kyuditsky/catpaw/README.md

# catpaw
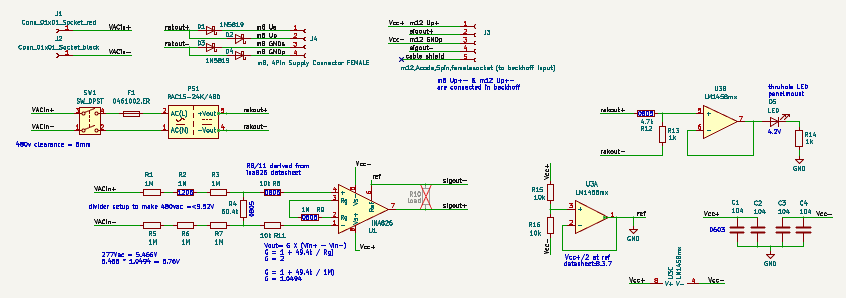
[picture p1: images/catpaw_scheme_072026.png]


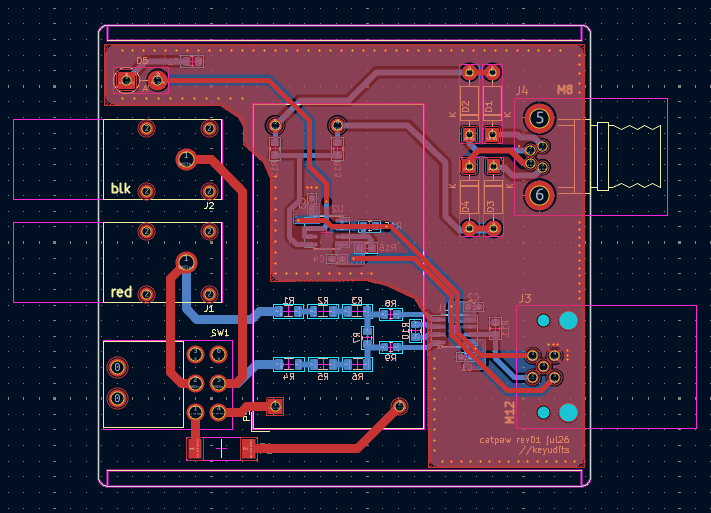
[picture p2: images/catpaw_pcbnew_route03.png]
