kyuditsky/catpaw/images/1MD1TB1M6QES.png

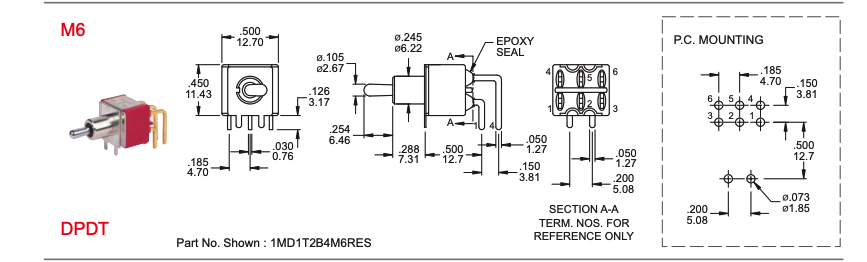
images/1MD1TB1M6QES.png
