kyuditsky/catpaw/images/catpaw2-0_pcb.png

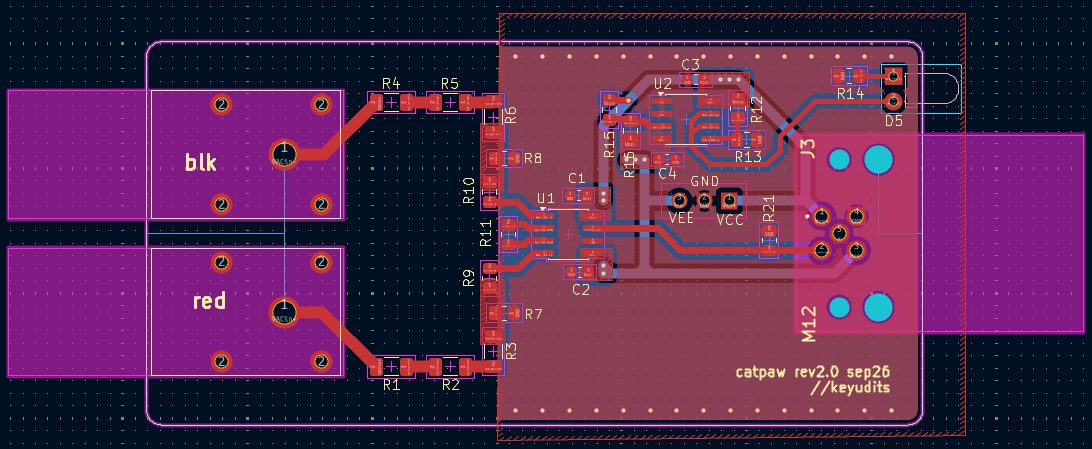
images/catpaw2-0_pcb.png
