kyuditsky/catpaw/images/catpaw2-0_scheme.png

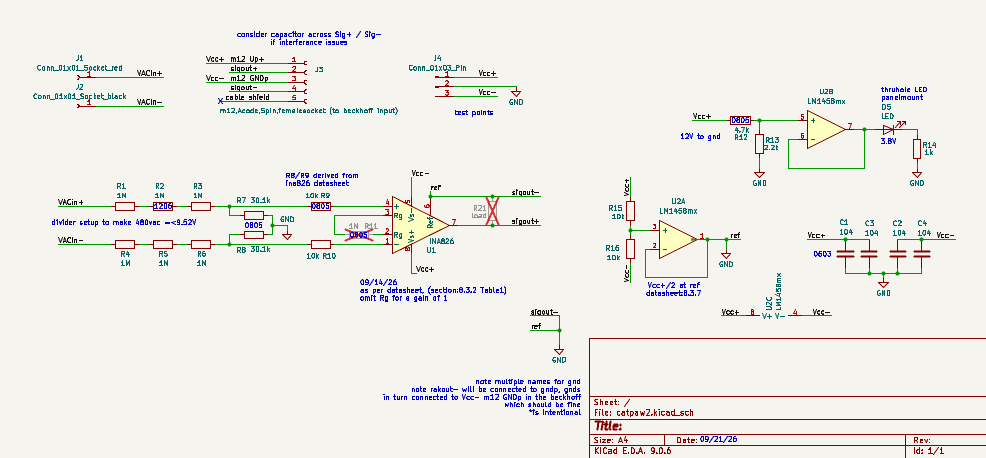
images/catpaw2-0_scheme.png
