kyuditsky/catpaw/images/catpaw_div1.png

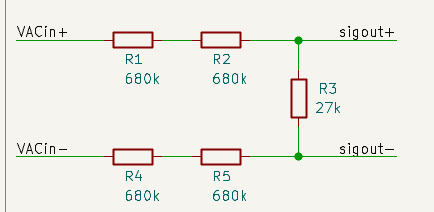
images/catpaw_div1.png
