kyuditsky/catpaw/images/catpaw_div2.png

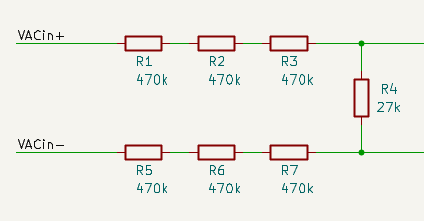
images/catpaw_div2.png
