kyuditsky/catpaw/images/catpaw_div3.png

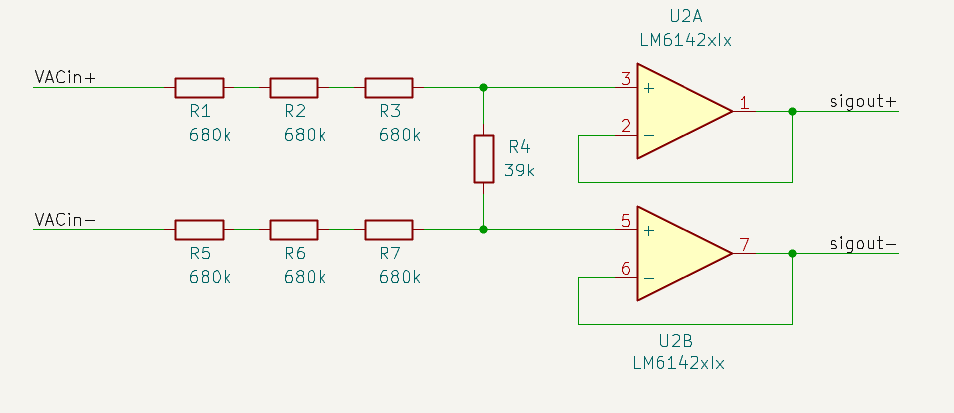
images/catpaw_div3.png
