kyuditsky/catpaw/images/catpaw_div4.png

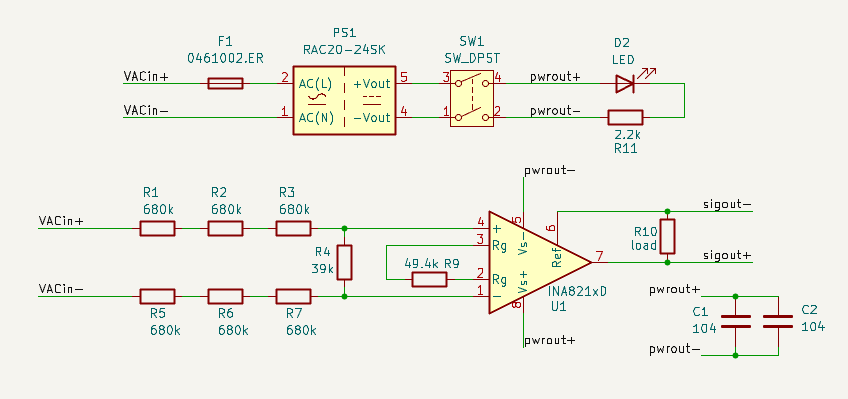
images/catpaw_div4.png
