kyuditsky/catpaw/images/catpaw_draft1.png

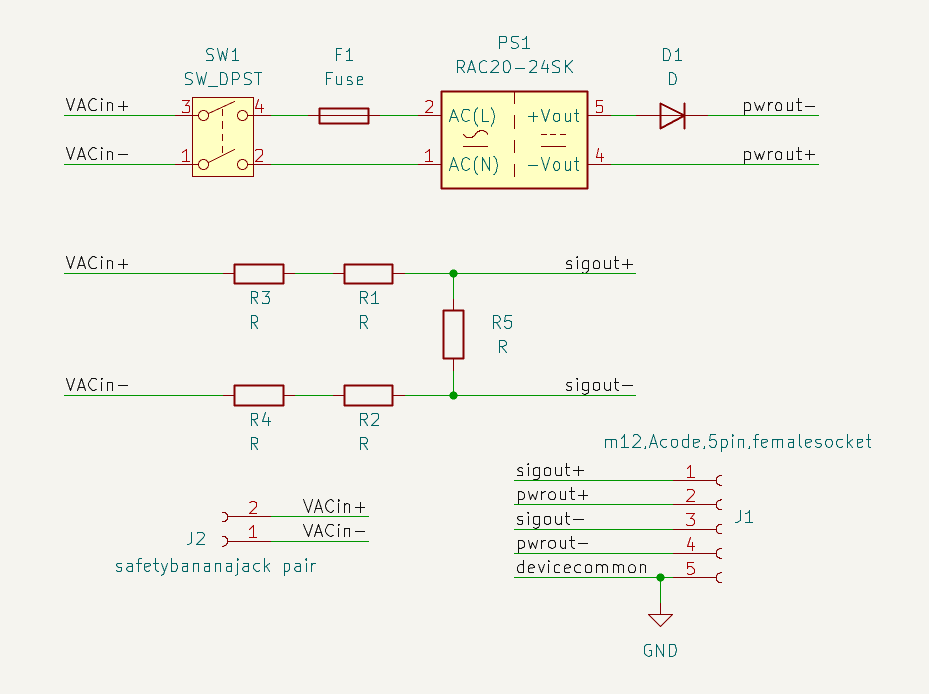
images/catpaw_draft1.png
