kyuditsky/catpaw/images/catpaw_pcbnew_route01.png

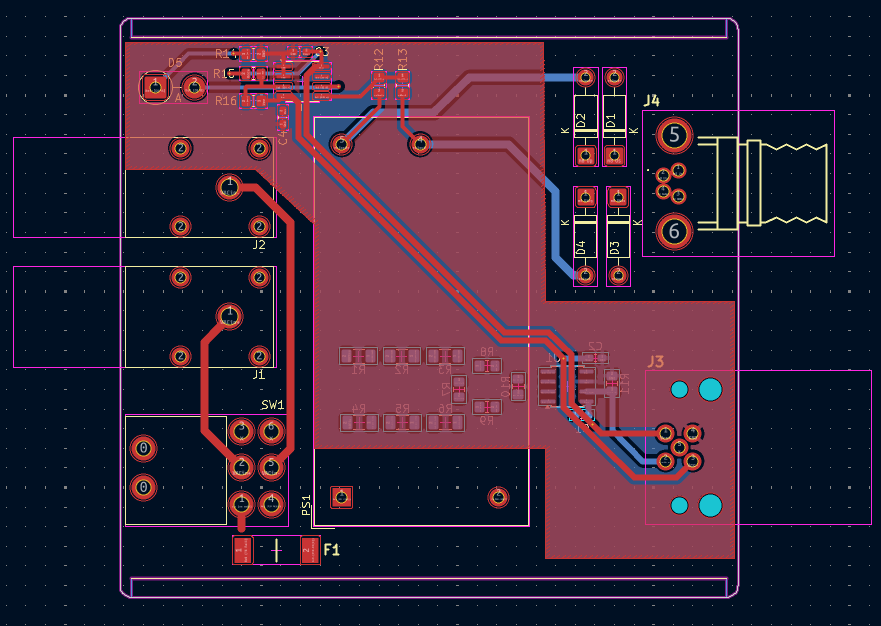
images/catpaw_pcbnew_route01.png
