kyuditsky/catpaw/images/catpaw_rev2_prod1.png

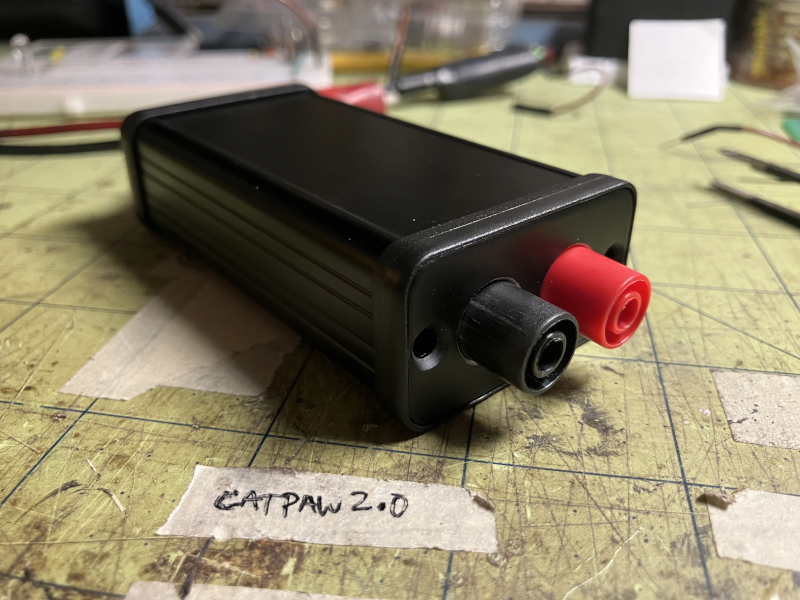
images/catpaw_rev2_prod1.png
