kyuditsky/catpaw/images/catpaw_rev2_prod2.png

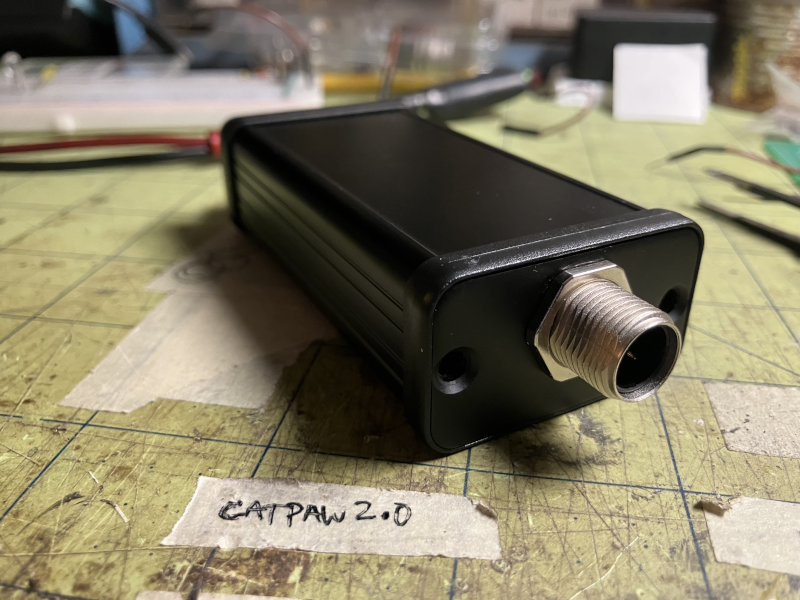
images/catpaw_rev2_prod2.png
