kyuditsky/catpaw/images/catpaw_scheme051226_02.png

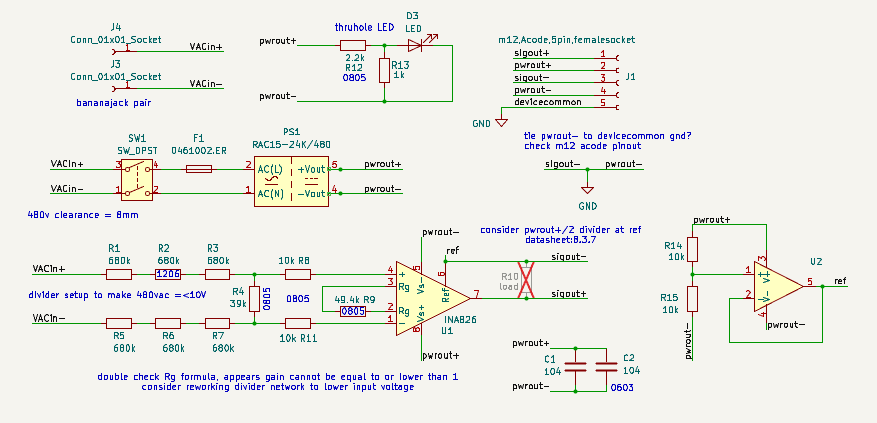
images/catpaw_scheme051226_02.png
