kyuditsky/catpaw/images/catpaw_scheme051326_01.png

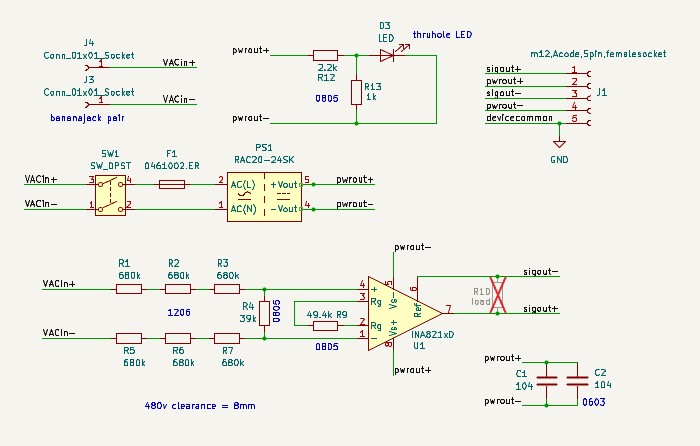
images/catpaw_scheme051326_01.png
