kyuditsky/catpaw/images/catpaw_scribbles.png

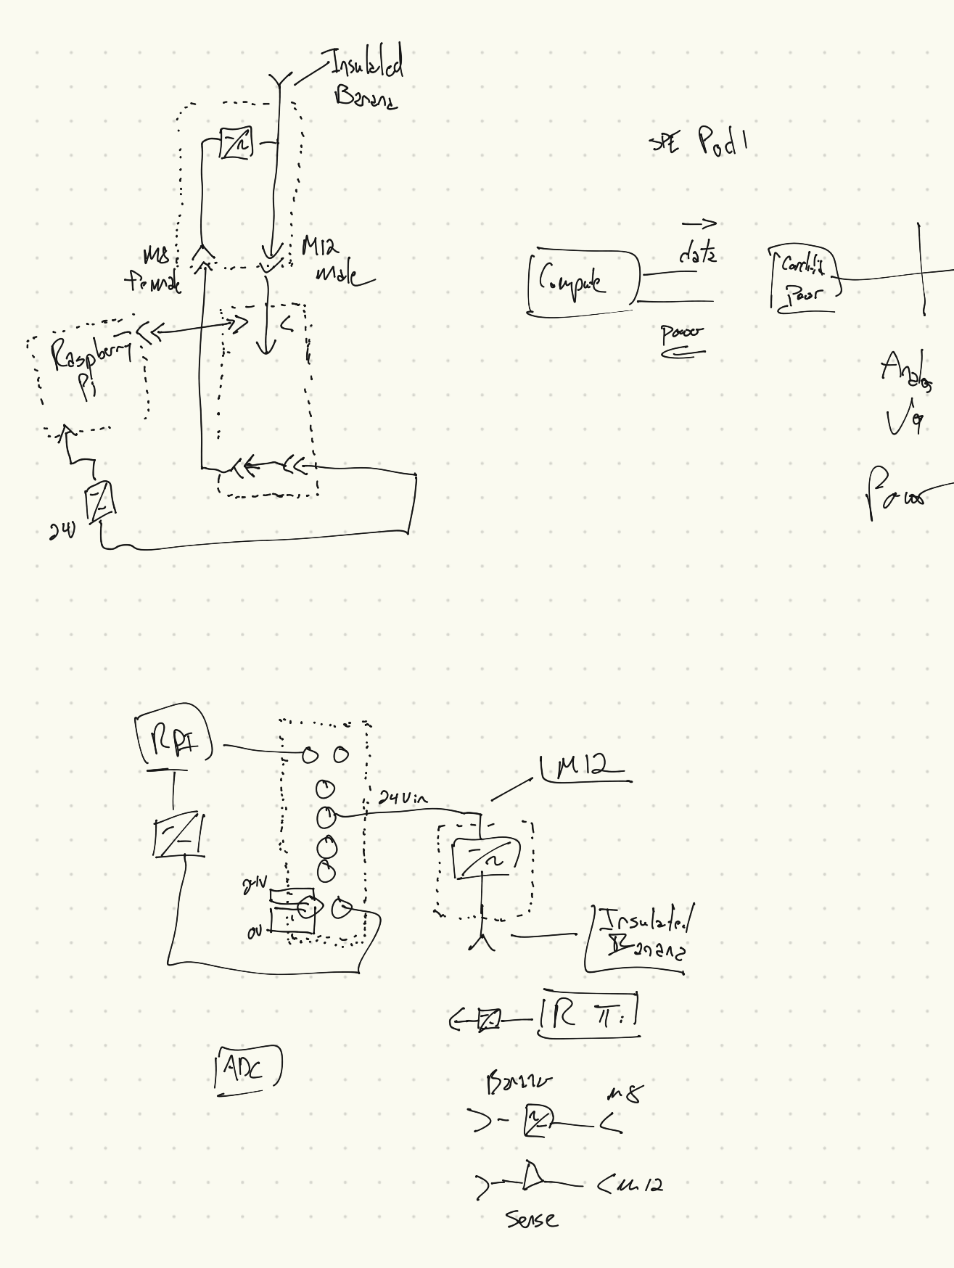
images/catpaw_scribbles.png
