kyuditsky/catpaw/images/catpawrev01_01.png

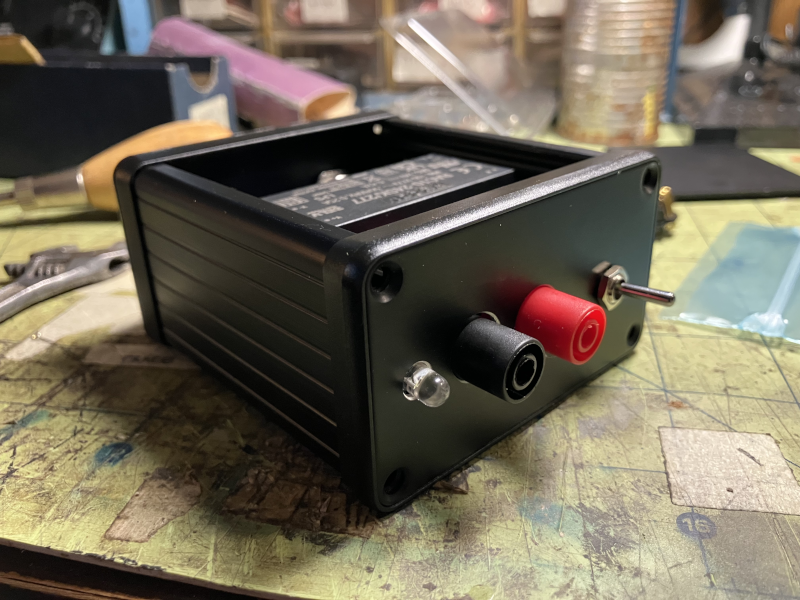
images/catpawrev01_01.png
