kyuditsky/catpaw/images/catpawrev01_02.png

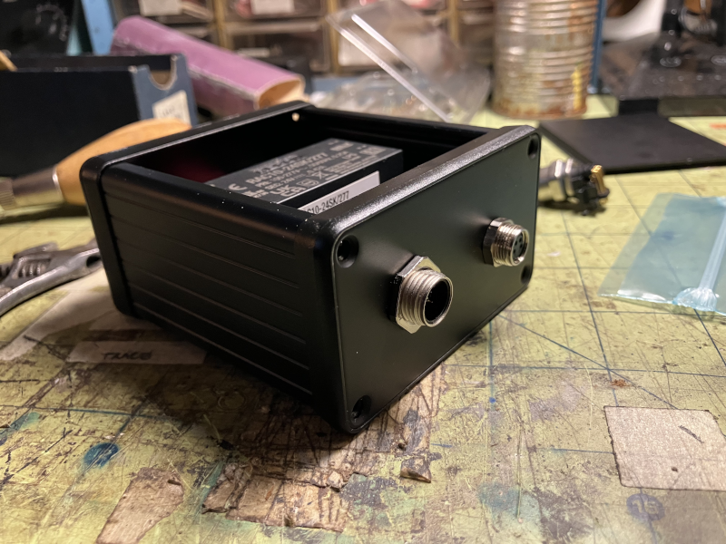
images/catpawrev01_02.png
