kyuditsky/catpaw/images/catpawrev01_03.png

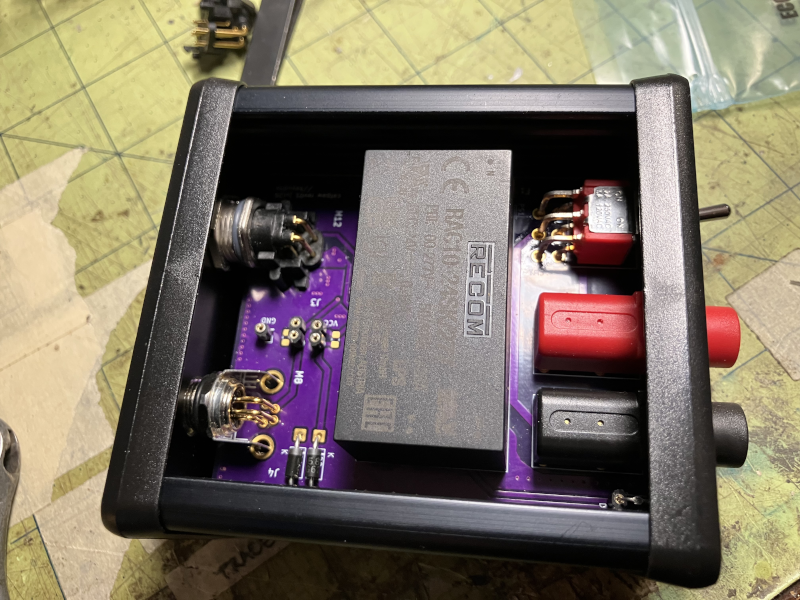
images/catpawrev01_03.png
