kyuditsky/catpaw/images/fatpaw1-1_pcb.png

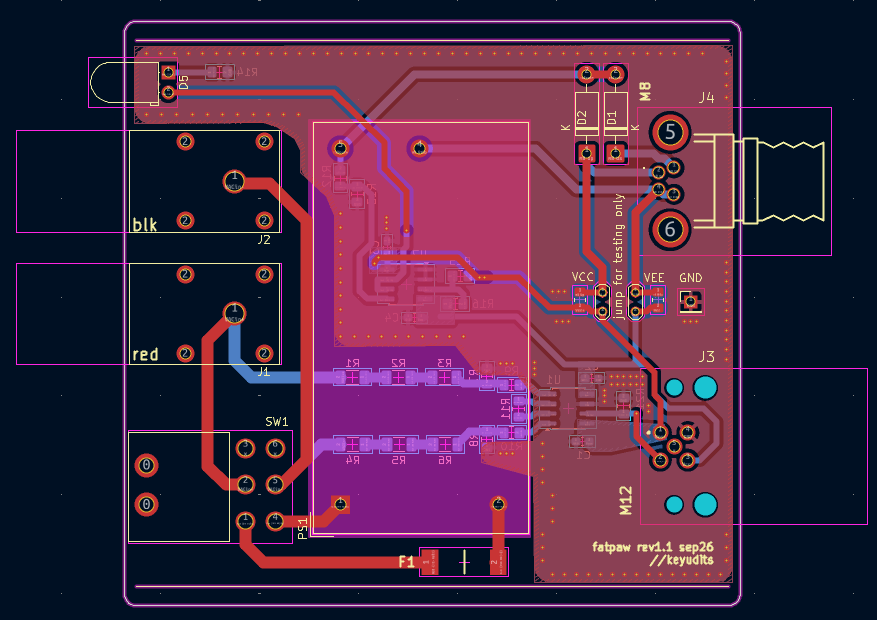
images/fatpaw1-1_pcb.png
