kyuditsky/catpaw/images/INA826.png

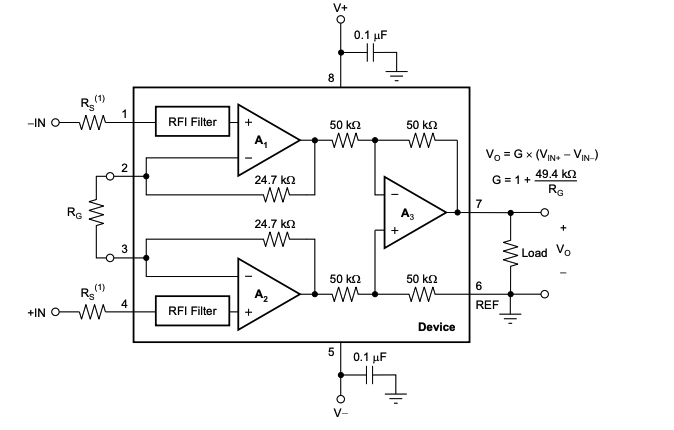
images/INA826.png
