kyuditsky/catpaw/images/led_Divider.png

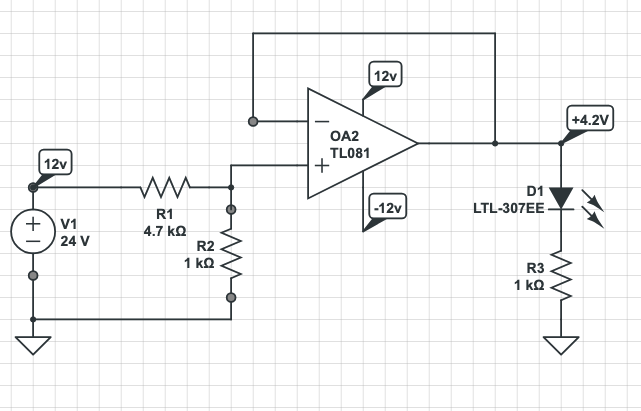
images/led_Divider.png
