kyuditsky/catpaw/images/plot_VacinL.png

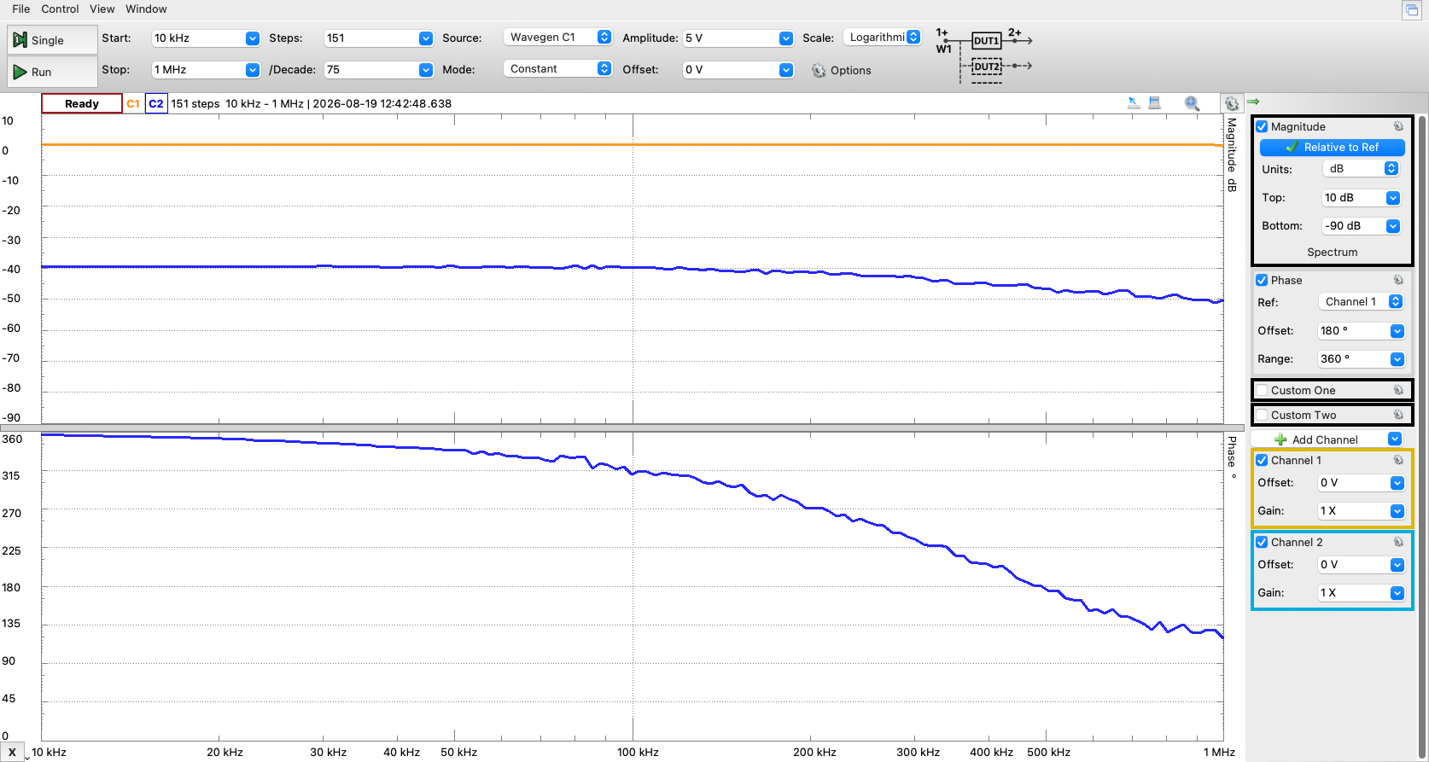
images/plot_VacinL.png
