kyuditsky/catpaw/images/plot_VacinN.png

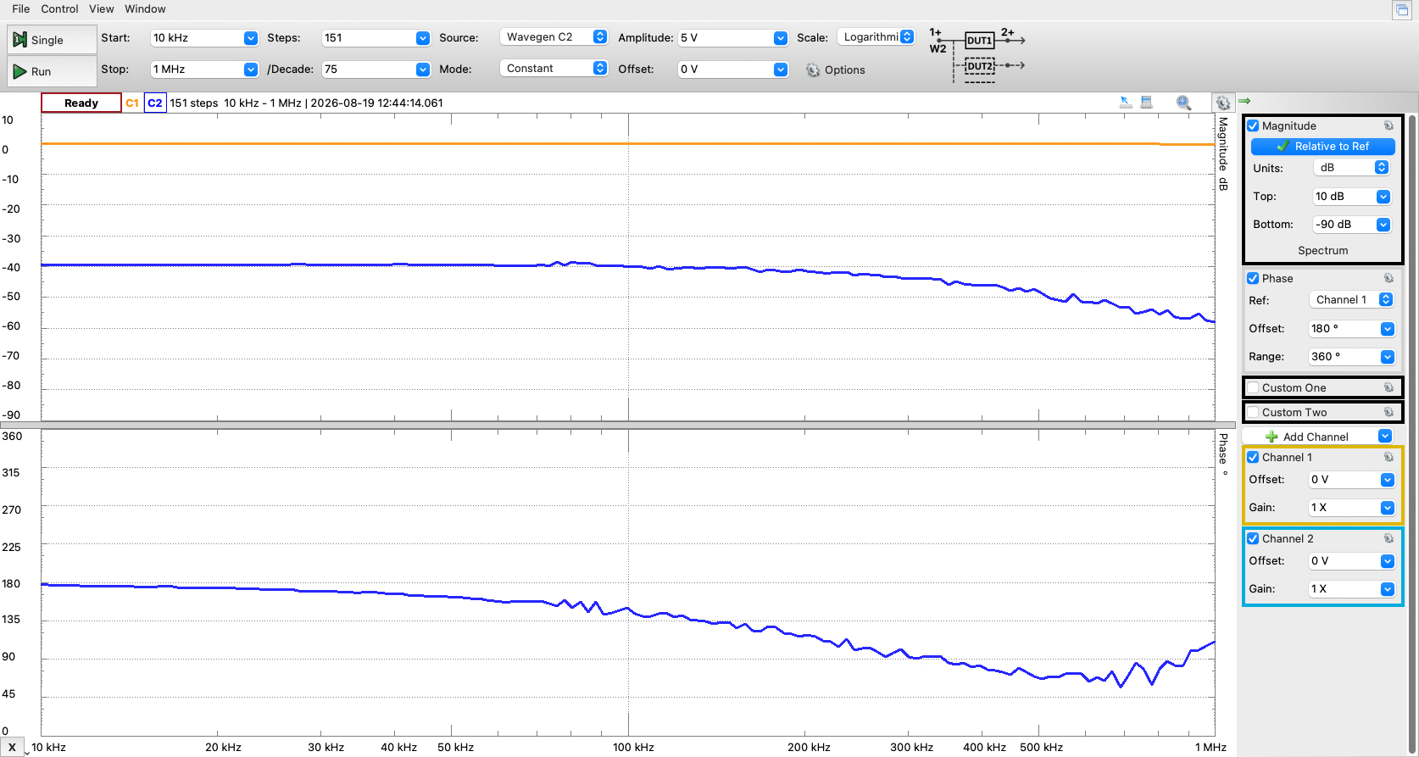
images/plot_VacinN.png
