kyuditsky/catpaw/images/scopetestv01/catpaw120vac_10kload_nopower02.png

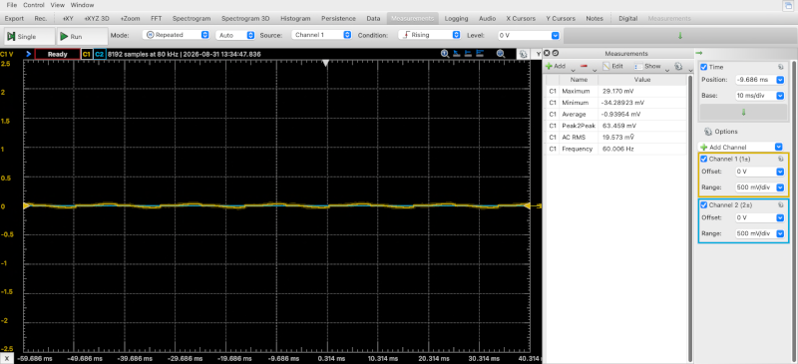
images/scopetestv01/catpaw120vac_10kload_nopower02.png
