kyuditsky/catpaw/images/scopetestv01/catpaw_input2kreturnpath01.png

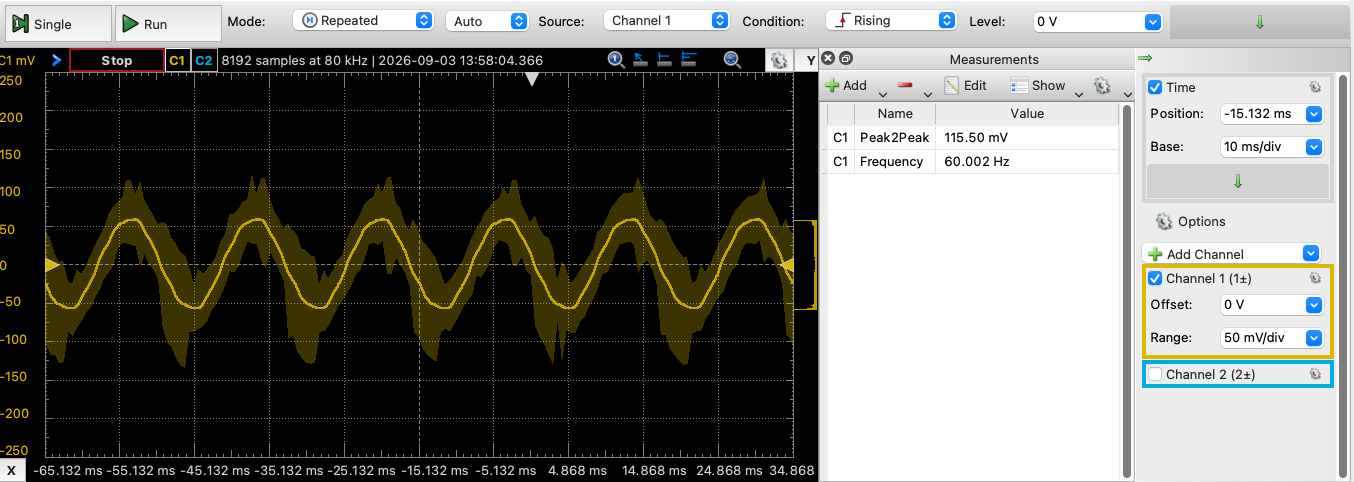
images/scopetestv01/catpaw_input2kreturnpath01.png
