kyuditsky/catpaw/images/scopetestv01/catpaw_input60kreturnpath01.png

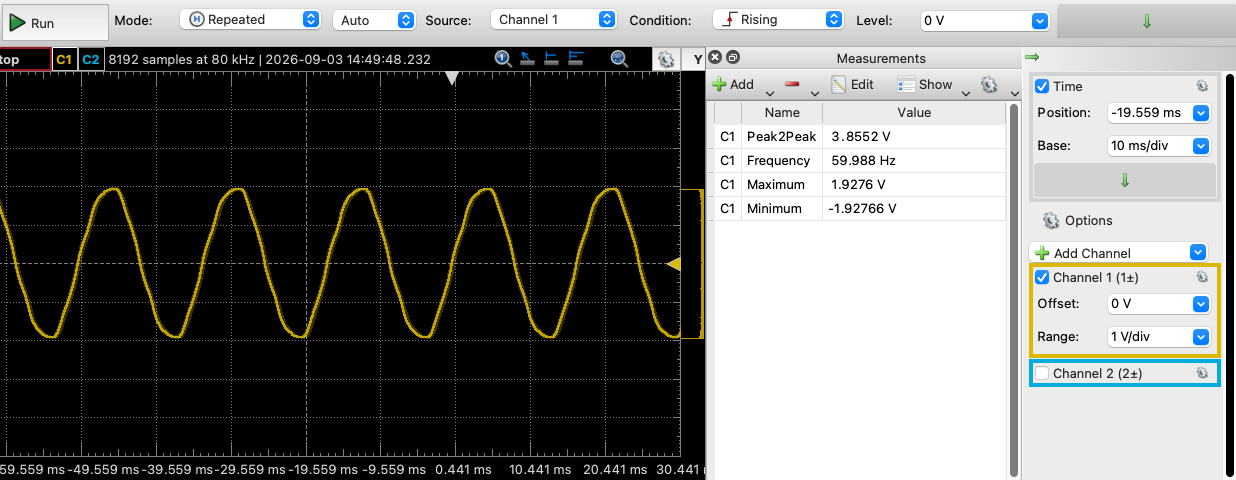
images/scopetestv01/catpaw_input60kreturnpath01.png
