kyuditsky/catpaw/images/scopetestv01/catpawbode_rev10L.png

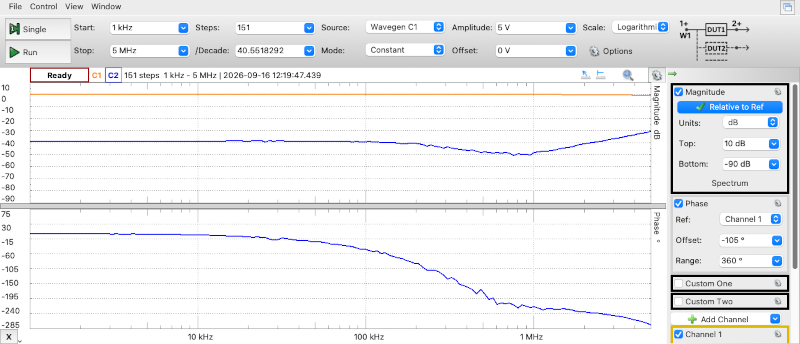
images/scopetestv01/catpawbode_rev10L.png
