kyuditsky/catpaw/images/scopetestv01/dadbod120v_into_catpaw01.png

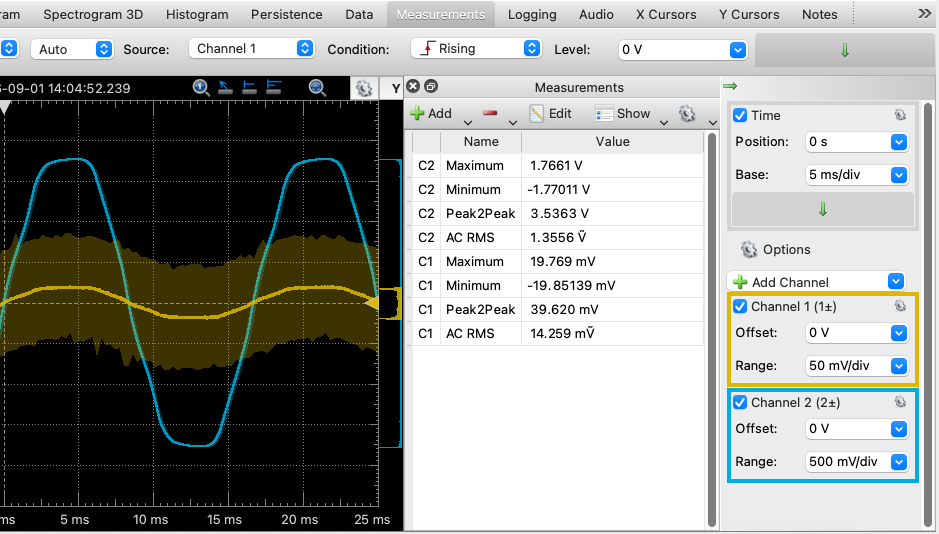
images/scopetestv01/dadbod120v_into_catpaw01.png
