kyuditsky/catpaw/images/scopetestv01/dadbod_120vac01.png

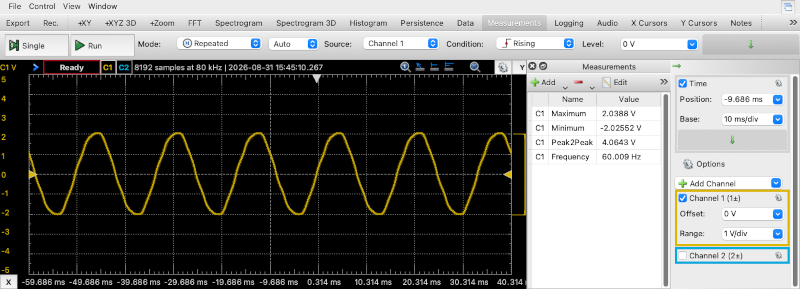
images/scopetestv01/dadbod_120vac01.png
