kyuditsky/catpaw/images/scopetestv01/plot_vacinL03.png

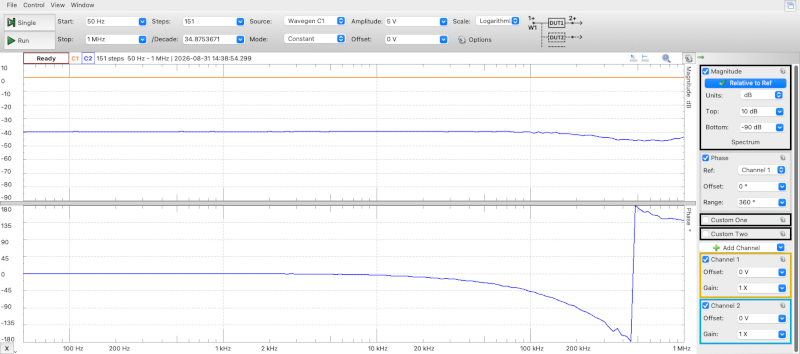
images/scopetestv01/plot_vacinL03.png
