kyuditsky/catpaw/images/scopetestv01/scope_waveform02.png

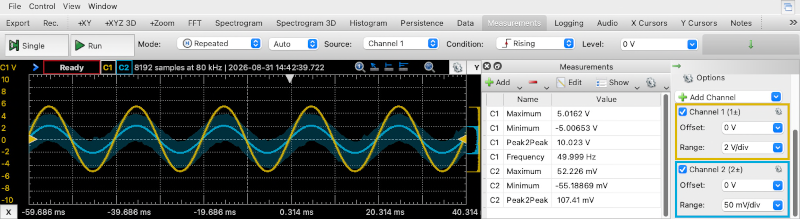
images/scopetestv01/scope_waveform02.png
