kyuditsky/catpaw/images/scopetestv20/catpawbode_rev20L.png

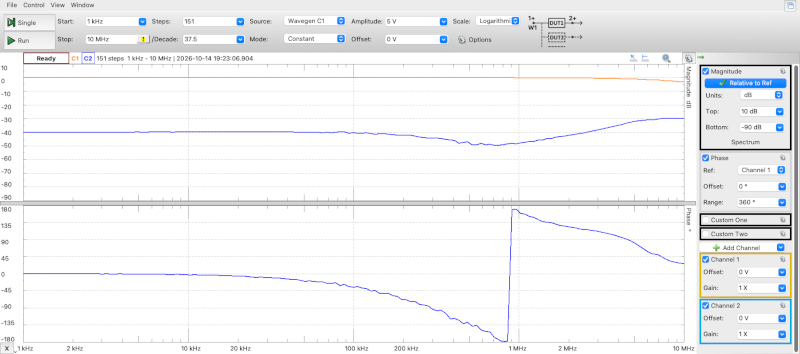
images/scopetestv20/catpawbode_rev20L.png
