kyuditsky/catpaw/images/scopetestv20/catpawbode_rev20N.png

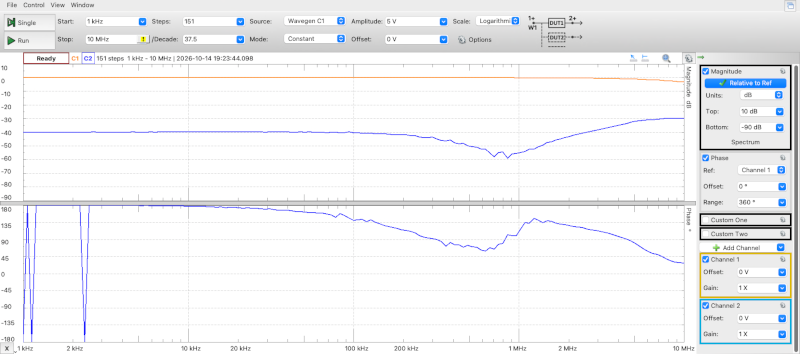
images/scopetestv20/catpawbode_rev20N.png
