kyuditsky/catpaw/kicad/Rev1-1-fatpaw/sim/01-AC-smallsignal_in-out.png

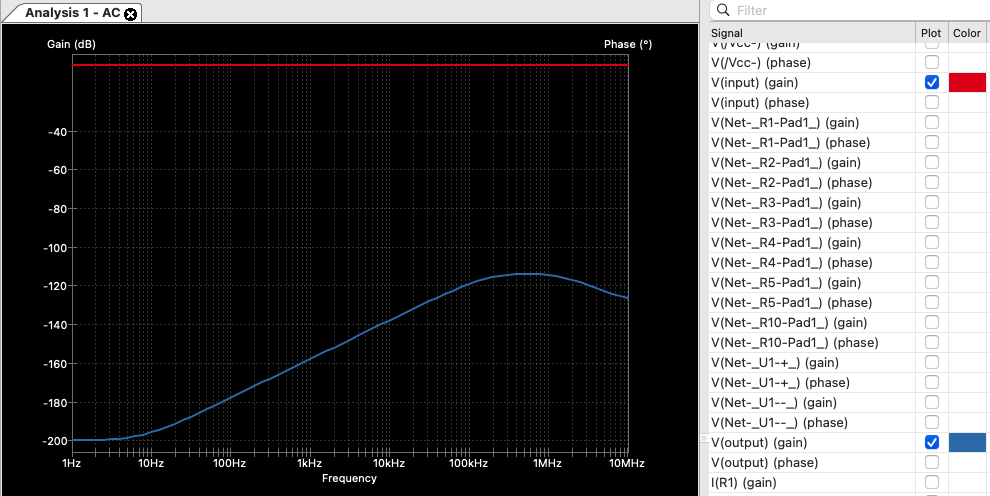
kicad/Rev1-1-fatpaw/sim/01-AC-smallsignal_in-out.png
