kyuditsky/catpaw/kicad/Rev1-1-fatpaw/sim/02-AC-smalsignal_in-out-fixed.png

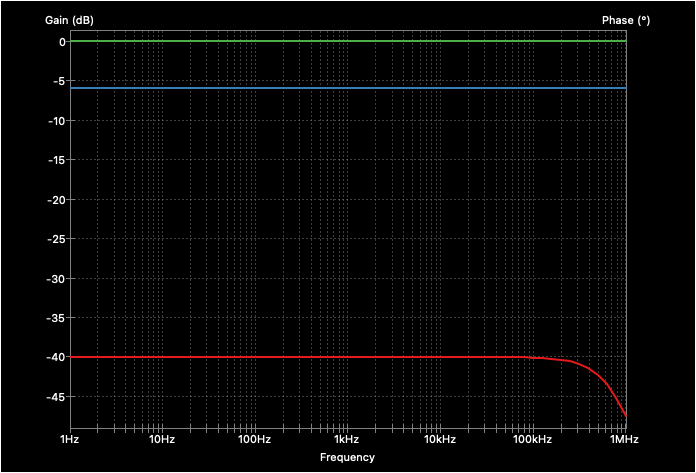
kicad/Rev1-1-fatpaw/sim/02-AC-smalsignal_in-out-fixed.png
