kyuditsky/catpaw/BOM/catpaw_parts_bom01/Catpaw_MouserCart_Jul23_1238PM.xls

SHOPPING CART
This is not an invoice
23-Jul-26 11:38:39
 | Mouser # | Mfr. # | Manufacturer | Customer # | Description | RoHS | Lifecycle | Order Qty. | Price (USD) | Ext.: (USD) | Estimated Tariff Price (USD) | Estimated Tariff Ext. (USD)
1 | 603-CC603KRX7R9BB104 | CC0603KRX7R9BB104 | YAGEO | C1,C2,C3,C4 | Multilayer Ceramic Capacitors MLCC - SMD/SMT 50 V 0.1uF X7R 0603 10% | RoHS Compliant |  | 40 | $0.03 | $1.20 | $0.00 | $0.08
2 | 821-1N5819 | 1N5819 | Taiwan Semiconductor | D1,D2,D3,D4 | Schottky Diodes & Rectifiers 1A, 40V, Schottky Rectifier | RoHS Compliant By Exemption |  | 2 | $0.32 | $0.64 | $0.12 | $0.24
3 | 941-C503BAASCZ0C0342 | C503B-AAS-CZ0C0342 | Cree LED | D5 | Single Color LEDs AMBER EMITTING LED | RoHS Compliant | New Product | 10 | $0.19 | $1.90
4 | 576-0461002.ER | 0461002.ER | Littelfuse | F1 | Surface Mount Fuses 600VAC 2A .045ohms 461 NANO2 | RoHS Compliant By Exemption |  | 2 | $1.94 | $3.88
5 | 523-M12A05PFFRSF7003 | M12A-05PFFR-SF7003 | Amphenol | J3 | Sensor Cables / Actuator Cables M12 Circular Metric Connector, A Code, Metal, 4A, 05 pins, Female Connector, Female Contact, Hexagonal, M12*1.0, Screw Thread, PCB 90 , Receptacle, Front Fastened, IP67 Mated |  |  | 2 | $7.98 | $15.96 | $0.64 | $1.28
6 | 179-DM84504AFPF01067 | CDM845-04A-FP-F010-67 | Same Sky | J4 | Circular Metric Connectors 4 Pins, PCB Panel Mount, PC Pins, Right Angle, Front Fastened M8 x 1.0, A-Coding, Screw Copper Alloy, IP67, M8 Female Circular Connector Jack | RoHS Compliant | New Product | 2 | $7.67 | $15.34 | $1.53 | $3.06
7 | 71-CRMV1206AF1M00FKF | CRMV1206AF1M00FKEF | Vishay | R1,R2,R3,R4,R5,R6 | Thick Film Resistors - SMD 0.30W 1Mohms 1% AEC-Q200 | RoHS Compliant By Exemption | New Product | 12 | $0.413 | $4.96 | $0.04 | $0.49
8 | 71-CRCW0805-60.4K-E3 | CRCW080560K4FKEA | Vishay | R7 | Thick Film Resistors - SMD 1/4W 60.4Kohms 1% 100ppm | RoHS Compliant By Exemption |  | 20 | $0.028 | $0.56 | $0.00 | $0.06
9 | 71-RCC08051M00FKEA | RCC08051M00FKEA | Vishay | R10 | Thick Film Resistors - SMD 1/4W 1Mohms 1% 100ppm | RoHS Compliant By Exemption |  | 20 | $0.109 | $2.18 | $0.01 | $0.22
10 | 71-CRCW08054K70FKEC | CRCW08054K70FKEC | Vishay | R12 | Thick Film Resistors - SMD D12/CRCW0805 100 4K7 1% ET6 e3 | RoHS Compliant By Exemption |  | 20 | $0.028 | $0.56
11 | 118-1MD1T1B1M6QES | 1MD1T1B1M6QES | Dailywell | SW1 | Toggle Switches toggle DPDT switch on-on right angle pc thru-hole | RoHS Compliant By Exemption |  | 2 | $5.55 | $11.10
12 | 595-INA826AIDR | INA826AIDR | Texas Instruments | U1 | Instrumentation Amplifiers Prec 200uA Sply Crnt 36V Supply Instr Am A 595-INA826AID | RoHS Compliant |  | 2 | $3.95 | $7.90
13 | 546-1455K801BK | 1455K801BK | Hammond | Enclosure | Enclosures, Boxes, & Cases 80 X 78 X 43MM EXTRUDED BOX | RoHS Compliant | New Product | 1 | $25.02 | $25.02
14 | 71-CRCW08052K20FKEC | CRCW08052K20FKEC | Vishay | Rx | Thick Film Resistors - SMD 2.2K OHM 1% | RoHS Compliant By Exemption |  | 20 | $0.028 | $0.56
15 | 576-SMCJ5.0CA | SMCJ5.0CA | Littelfuse | TVS | ESD Protection Diodes / TVS Diodes 1.5kW 5V 5% Bi-Directional | RoHS Compliant By Exemption |  | 5 | $0.76 | $3.80 | $0.34 | $1.71
16 | 919-RAC15-24SK/480 | RAC15-24SK/480 | RECOM |  | Power Supplies - Board Mount 15W 85-528Vin 24Vout 625mA | RoHS Compliant |  | 1 | $24.77 | $24.77 | $7.43 | $7.43
By submitting your order you agree to these terms and conditions. (https://www.mouser.com/saleterms) |  |  |  |  |  |  |  |  |  |  | Merchandise: | $120.33
Prices are reflected at the date and time shown. |  |  |  |  |  |  |  |  |  |  | Shipping Charge: | $9.39
 |  |  |  |  |  |  |  |  |  |  | Estimated Tariff: | $14.57
