kyuditsky/catpaw/kicad/Rev1-1-fatpaw/sim/INA826_sbomc48/INA826_TEST_CIRCUIT.png

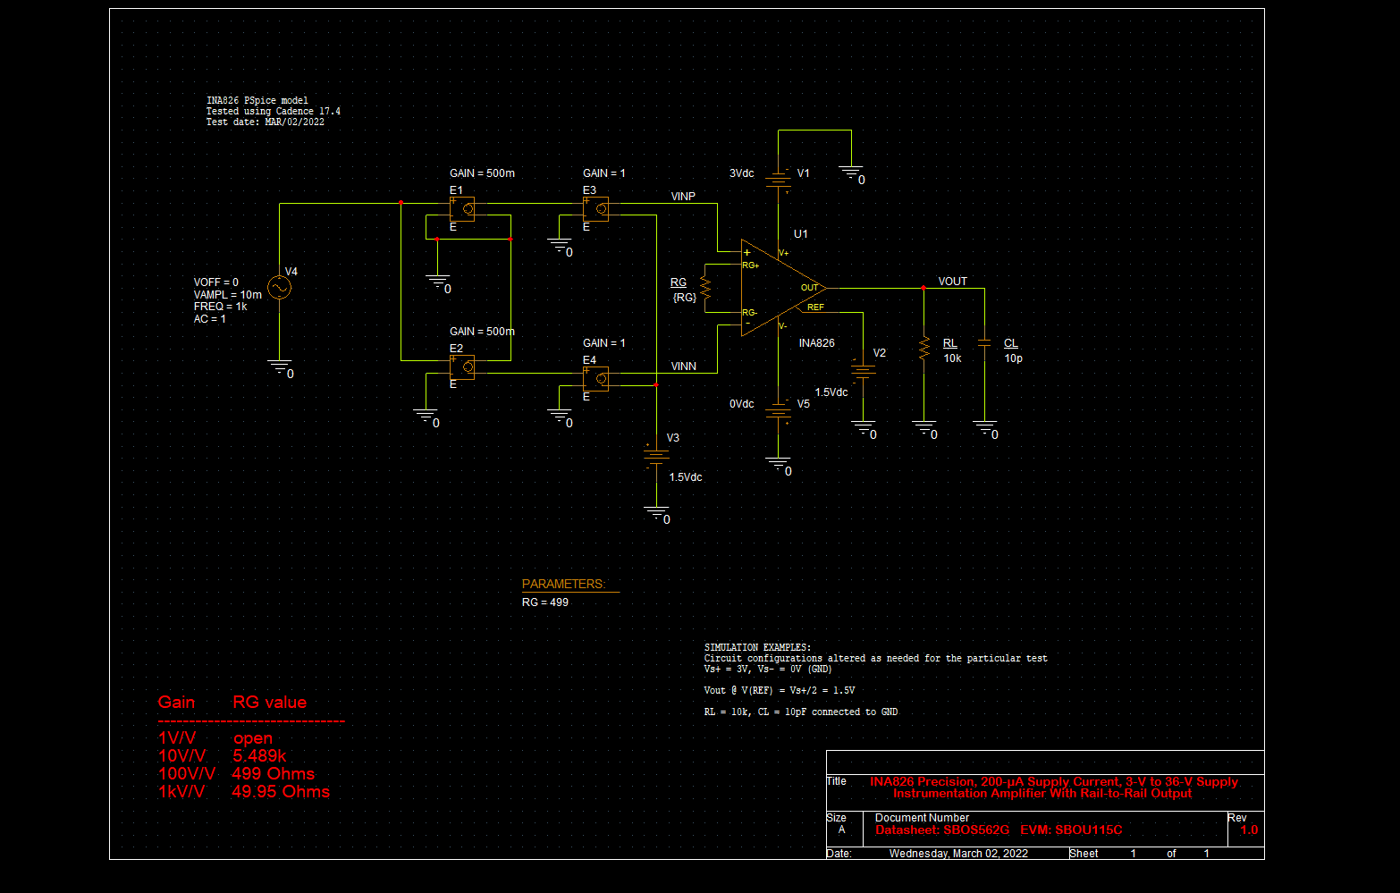
kicad/Rev1-1-fatpaw/sim/INA826_sbomc48/INA826_TEST_CIRCUIT.png
