kyuditsky/catpaw/ME-IO-S_55/PxC_1632614_01_00_ME-IO-S55CPU100PCB_TECDOC2D-PCB-Outline.pdf

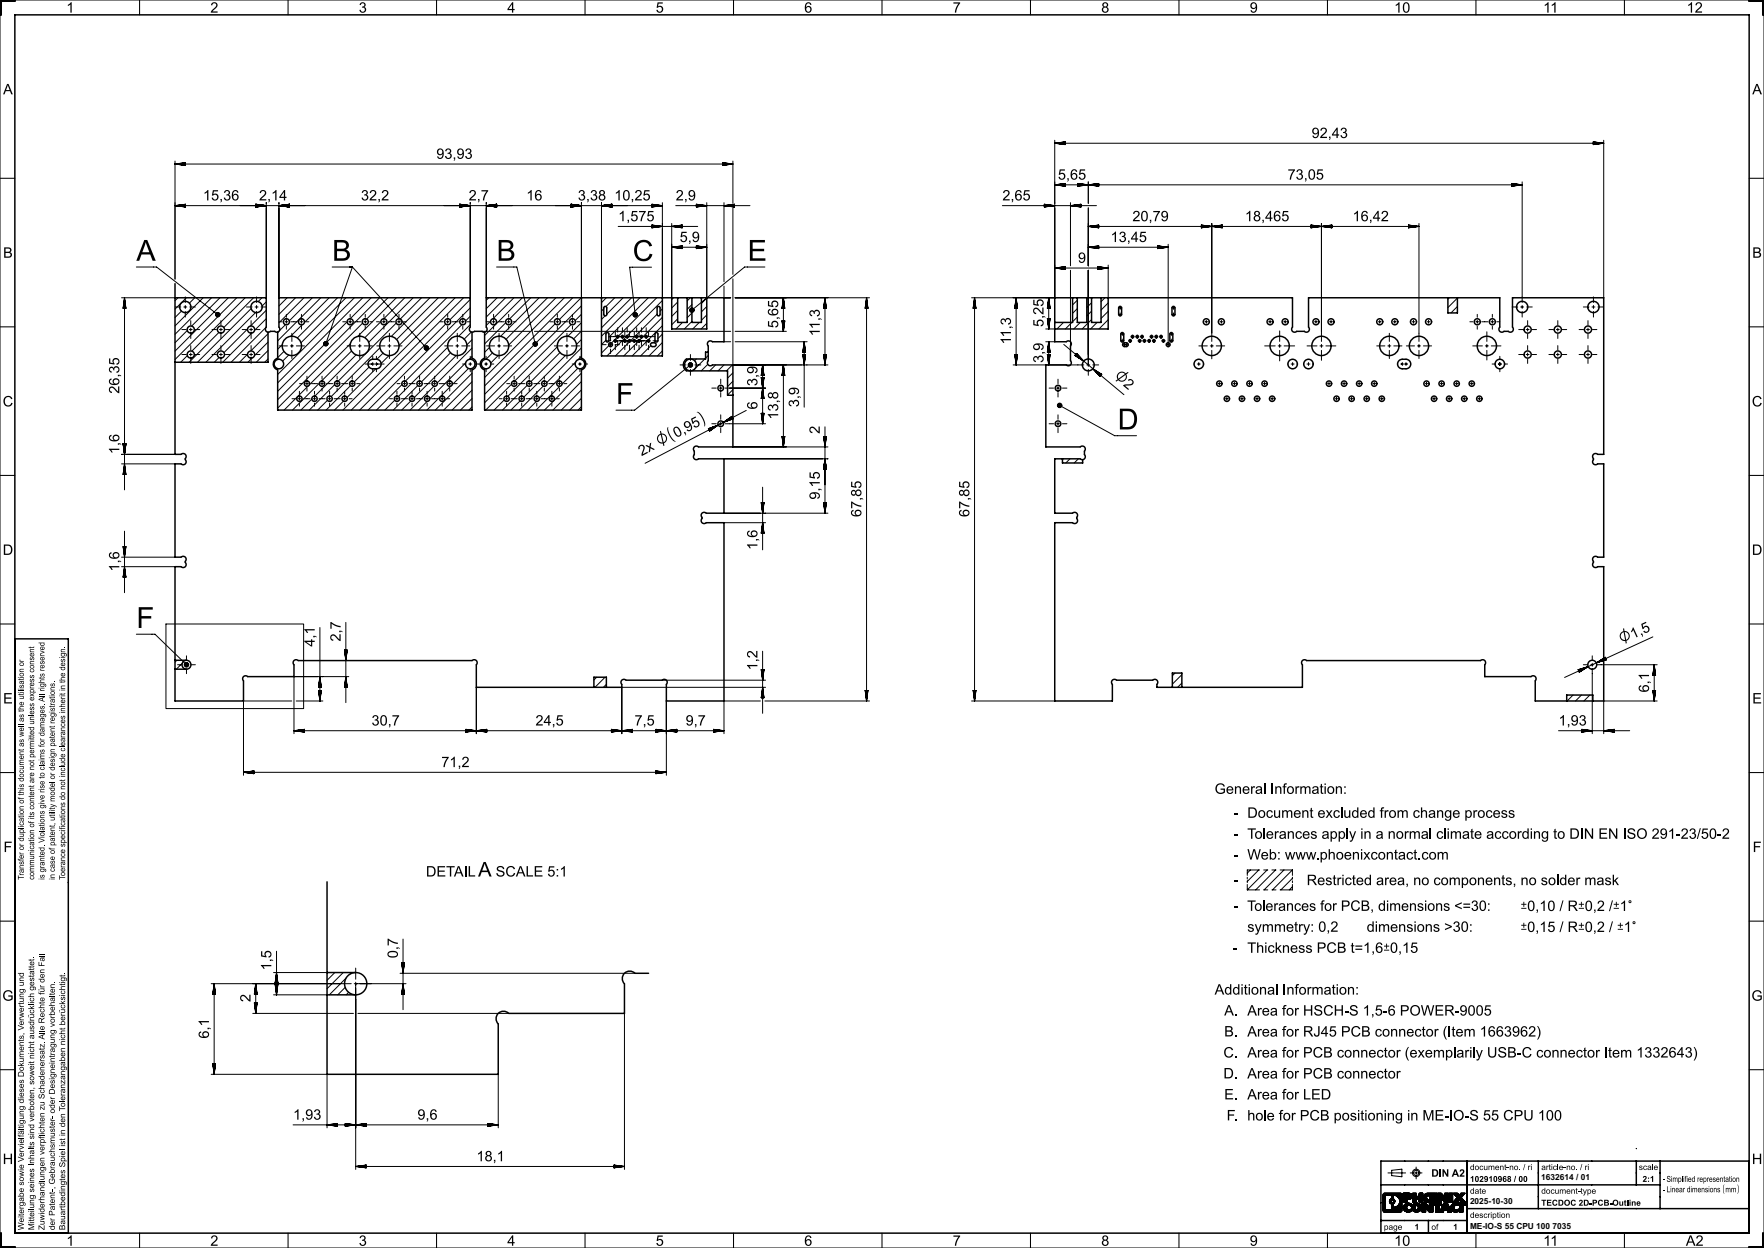
[picture p41: page 1]

ME-IO-S 55 CPU 100 7035
