kyuditsky/catpaw/ME-IO-S_55/pxc_1632614_01_01_ME-IO-S-55-CPU-100-7035_FAM.pdf

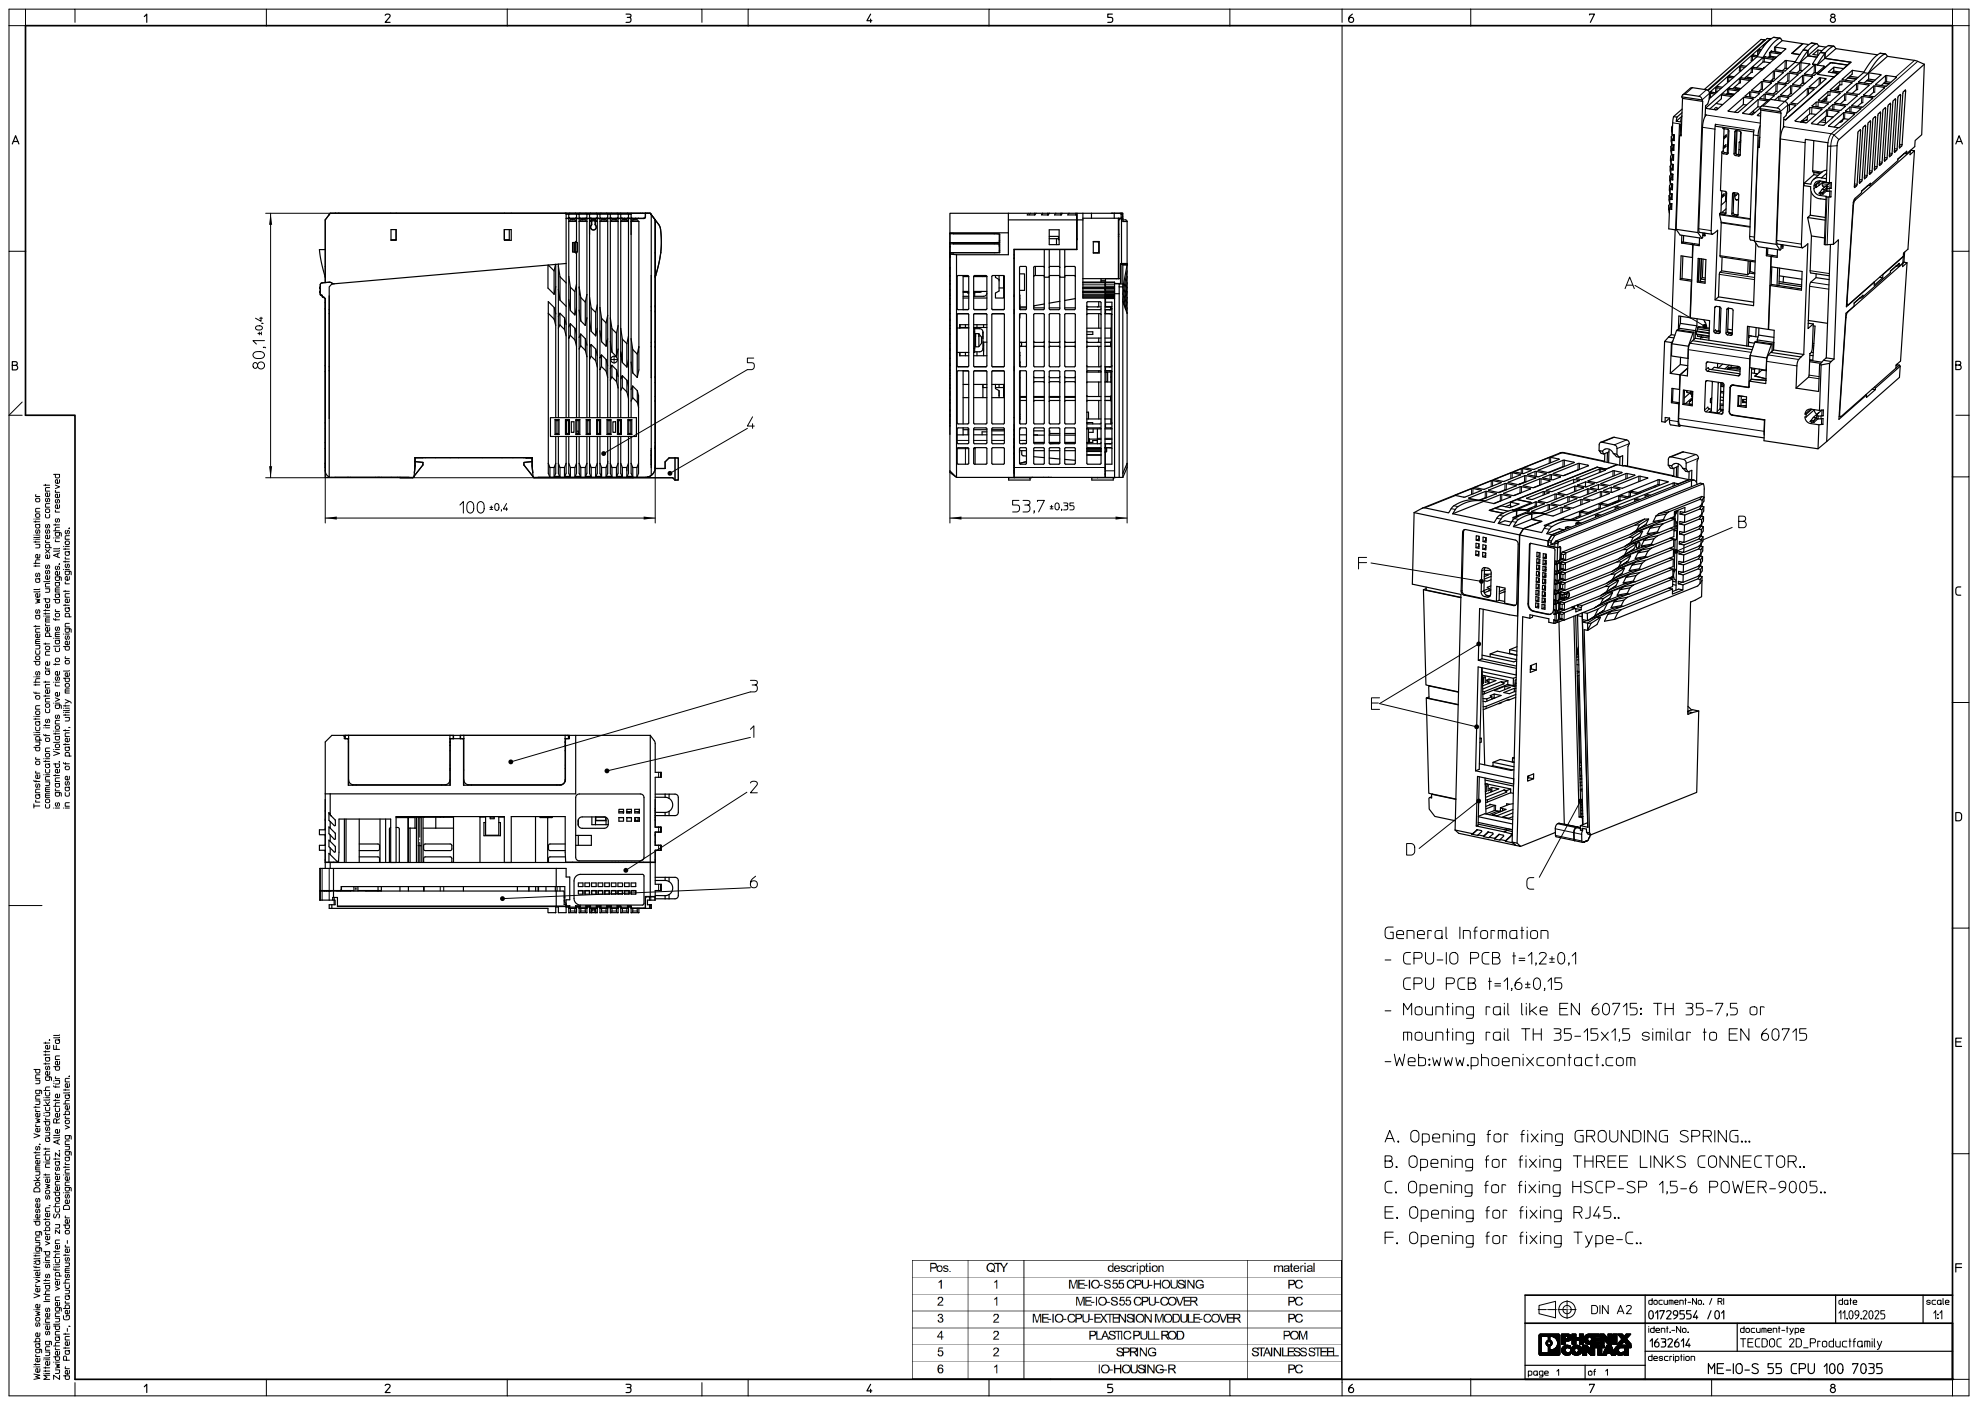
[picture p42: page 1]
