kyuditsky/catpaw/(list of files, drawings)

Other design files:
kicad/Rev1-1-fatpaw/sim/INA826_sbomc48/ina826.olb
kicad/Rev1-1-fatpaw/sim/INA826_sbomc48/ina826_test_circuit.opj
