kyuditsky/catpaw/kicad/Rev2-0-catpaw/catpaw2.kicad_pcb

## KiCad design kicad/Rev2-0-catpaw/catpaw2.kicad_pcb (2026-10-15)

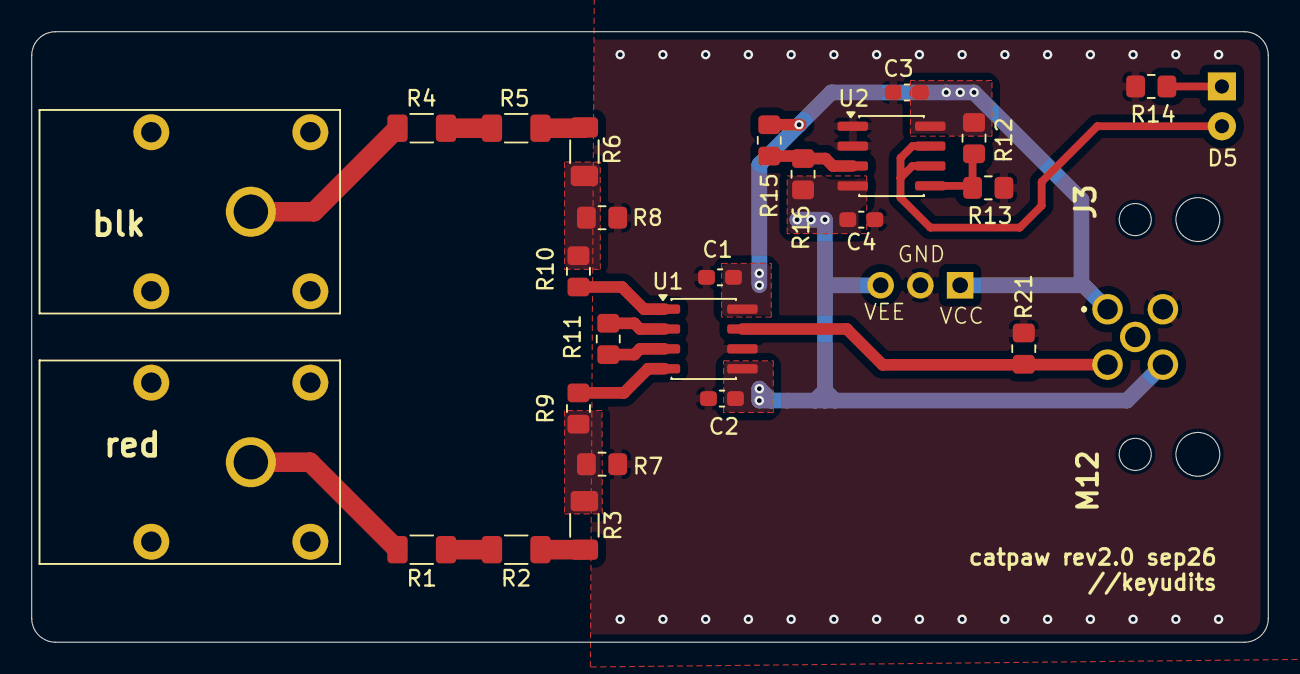
[picture p43: board catpaw2.kicad_pcb from above]

Board: 2 copper layers, 79.0 x 39.0 mm, 28 parts (1 on the bottom side), 20 nets.

Parts:
C1, C2, C3, C4: 104; C_0603_1608Metric_Pad1.08x0.95mm_HandSolder
D5: LED; LED_D3.0mm_Horizontal_O1.27mm_Z2.0mm
J1: Conn_01x01_Socket_red; Banana_Jack_S_RA_73099
J2: Conn_01x01_Socket_black; Banana_Jack_S_RA_73099
J3: m12,Acode,5pin,femalesocket (to beckhoff input); M12A05PFFRSF7003
J4: Conn_01x03_Pin; PinHeader_1x03_P2.54mm_Vertical
R1, R2, R3, R4, R5, R6: 1M; R_1206_3216Metric_Pad1.30x1.75mm_HandSolder
R7, R8: 30.1k; R_0805_2012Metric_Pad1.20x1.40mm_HandSolder
R9, R10, R15, R16: 10k; R_0805_2012Metric_Pad1.20x1.40mm_HandSolder
R11: 1M; R_0805_2012Metric_Pad1.20x1.40mm_HandSolder
R12: 4.7k; R_0805_2012Metric_Pad1.20x1.40mm_HandSolder
R13: 2.2k; R_0805_2012Metric_Pad1.20x1.40mm_HandSolder
R14: 1k; R_0805_2012Metric_Pad1.20x1.40mm_HandSolder
R21: load; R_0805_2012Metric_Pad1.20x1.40mm_HandSolder
U1: INA826; SOIC-8_3.9x4.9mm_P1.27mm
U2: LM1458mx; SOIC-8_3.9x4.9mm_P1.27mm

Connections:
/In+ Analog Input: J3.2, R21.1, U1.7
/VACin+: J1.1, R1.2
/VACin-: J2.1, R4.2
/Vcc+: C1.2, C3.2, J3.1, J4.1, R12.2, R15.2, U1.8 (Vs+), U2.8 (V+)
/Vcc-: C2.2, C4.2, J3.3, J4.3, R16.1, U1.5 (Vs-), U2.4 (V-)
GND: C1.1, C2.1, C3.1, C4.1, J3.4, J4.2, R7.1, R8.2, R13.2, R14.2, R21.2, U1.6 (Ref), U2.1, U2.2 (-)
unnamed: D5.2 (A), U2.6 (-), U2.7
unnamed: D5.1 (K), R14.1
unnamed: R1.1, R2.2
unnamed: R2.1, R3.2
unnamed: R3.1, R7.2, R9.1
unnamed: R4.1, R5.2
unnamed: R5.1, R6.2
unnamed: R6.1, R8.1, R10.1
unnamed: R11.1, U1.3 (Rg)
unnamed: R11.2, U1.2 (Rg)
unnamed: R9.2, U1.4 (+)
unnamed: R10.2, U1.1 (-)
unnamed: R15.1, R16.2, U2.3 (+)
unnamed: R12.1, R13.1, U2.5 (+)
