kyuditsky/catpaw/(commit log)

2026-07-14 scheme rework
    [catpaw.kicad_sch, scribble.kicad_sch]
2026-07-14 added M8 connector to RAK psu output
    [catpaw.kicad_sch]
2026-07-14 end of day
    [catpaw.kicad_sch]
2026-07-20 Reorganized file structure
    [catpaw.kicad_pcb, catpaw.kicad_sch, scribble.kicad_sch]
2026-07-20 Footprints assigned
    [0461002.ER.SchLib, 0461002.ER.stp, EDI2CAP.CFG, FUSC10131X312N.PcbLib, catpaw.kicad_sch, chips.prt, fusc10131x312n.psm, scribble.kicad_sch]
2026-07-20 added scheme screenshot
    [catpaw.kicad_sch]
2026-07-20 began pcbnew layout
    [catpaw.kicad_pcb, catpaw.kicad_sch]
2026-07-21 pcbnew initial route
    [catpaw.kicad_pcb, catpaw.kicad_sch]
2026-07-21 added pcbnew route 01
2026-07-21 pcbnew route v02
    [catpaw.kicad_pcb]
2026-07-21 pcbnew route03
    [catpaw.kicad_pcb]
2026-07-23 Exported BOM01, notes to scheme, touched up pcbnew
    [Catpaw_MouserCart_Jul23_1238PM.xls, catpaw.kicad_pcb, catpaw.kicad_sch]
2026-07-23 tidy up folders
    [0461002.ER.SchLib, 0461002.ER.stp, EDI2CAP.CFG, FUSC10131X312N.PcbLib, chips.prt, fusc10131x312n.psm]
2026-07-30 adjusted i/o placement
    [catpaw.kicad_pcb]
2026-07-30 added test points and jumpers
    [catpaw.kicad_pcb, catpaw.kicad_sch]
2026-07-30 generated gerbers
    [catpaw-B_Cu.gbl, catpaw-B_Mask.gbs, catpaw-B_Paste.gbp, catpaw-B_Silkscreen.gbo, catpaw-Edge_Cuts.gm1, catpaw-F_Cu.gtl, catpaw-F_Mask.gts, catpaw-F_Paste.gtp]
2026-08-03 updated gerbers, rev01 ordered
    [catpaw-B_Cu.gbl, catpaw-B_Mask.gbs, catpaw-B_Paste.gbp, catpaw-B_Silkscreen.gbo, catpaw-Edge_Cuts.gm1, catpaw-F_Cu.gtl, catpaw-F_Mask.gts, catpaw-F_Paste.gtp]
2026-08-21 updated parts.numbers, added bode plots
    [catpaw.kicad_pcb]
2026-08-24 updated bode plots, noted schematic
    [catpaw.kicad_sch]
2026-08-28 added rev01 buildout photos
    [catpaw.kicad_pcb]
2026-08-31 added vac scope images
    [catpaw.kicad_pcb]
2026-09-01 added more waveforms
    [catpaw.kicad_sch]
2026-09-16 Begin Rev1.1
    [catpaw.kicad_pcb, catpaw.kicad_sch]
2026-09-16 added new bode plots
    [catpaw.kicad_pcb, catpaw.kicad_sch]
2026-09-16 rev1.1 updates
    [catpaw.kicad_pcb]
2026-09-18 added sim.kicad
    [catpaw.kicad_pcb, ina826.olb, ina826_test_circuit.opj, sim.kicad_pcb, sim.kicad_sch]
2026-09-18 updated sim.kicad
    [sim.kicad_sch]
2026-09-21 forked catpaw-rev2, updated ina826 spice model
    [catpaw-B_Cu.gbl, catpaw-B_Mask.gbs, catpaw-B_Paste.gbp, catpaw-B_Silkscreen.gbo, catpaw-Edge_Cuts.gm1, catpaw-F_Cu.gtl, catpaw-F_Mask.gts, catpaw-F_Paste.gtp]
2026-09-21 routed rev2.0
    [catpaw2.kicad_pcb, catpaw2.kicad_sch]
2026-09-21 added fatpaw1.1 & catpaw2.0 gerbers
    [catpaw-B_Cu.gbl, catpaw-B_Mask.gbs, catpaw-B_Paste.gbp, catpaw-B_Silkscreen.gbo, catpaw-Edge_Cuts.gm1, catpaw-F_Cu.gtl, catpaw-F_Mask.gts, catpaw-F_Paste.gtp]
